Electro98/cyber-growbox-2077/README.md

# cyber-growbox-2077
This is the most epic student's growbox ever.
We hope that this project will help us to grow plants that will look 
like plants from Plants vs Zombies.
