Electro98/cyber-growbox-2077/blueprints/main_part.stl

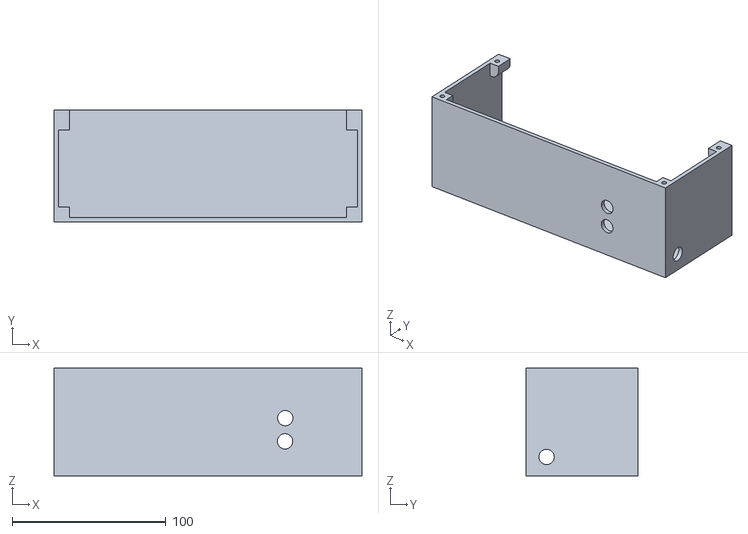
[picture p1: CAD file, 2021-03-17]
blueprints/main_part.stl
200.0 x 73.0 x 70.0
