Electro98/cyber-growbox-2077/blueprints/engine_mount.step

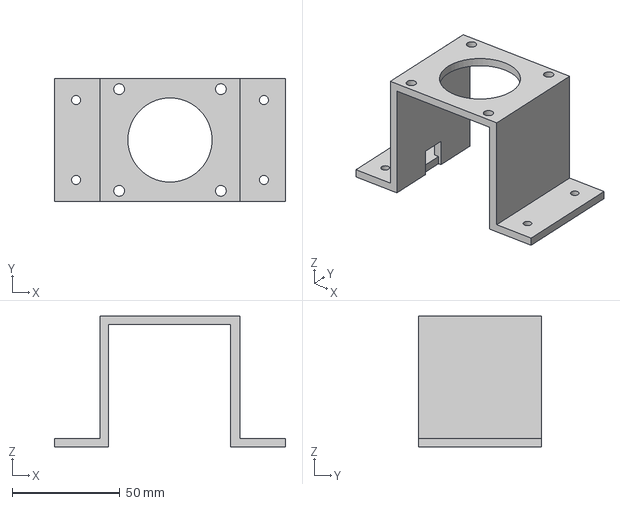
[picture p2: CAD file, 2021-03-21]
blueprints/engine_mount.step
107.0 x 57.0 x 60.6 mm
