Electro98/cyber-growbox-2077/blueprints/top_mount.step

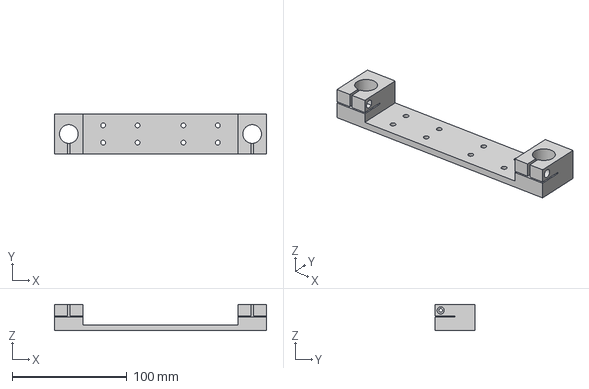
[picture p3: CAD file, 2021-03-21]
blueprints/top_mount.step
185.0 x 35.0 x 23.0 mm
