Electro98/cyber-growbox-2077/blueprints/bottom_mount.step

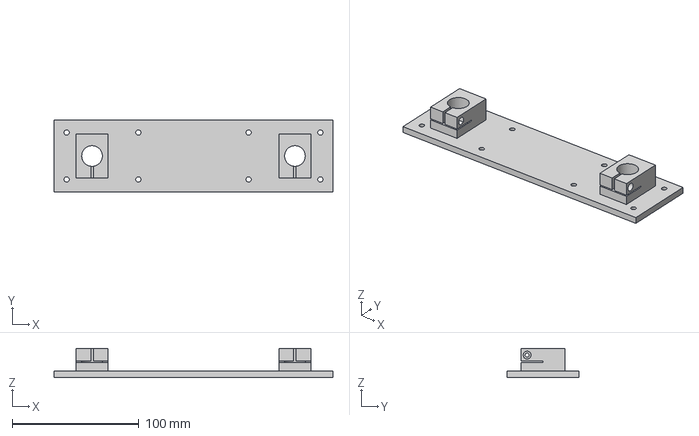
[picture p4: CAD file, 2021-03-21]
blueprints/bottom_mount.step
220.0 x 57.0 x 23.0 mm
