Electro98/cyber-growbox-2077/blueprints/carriage.step

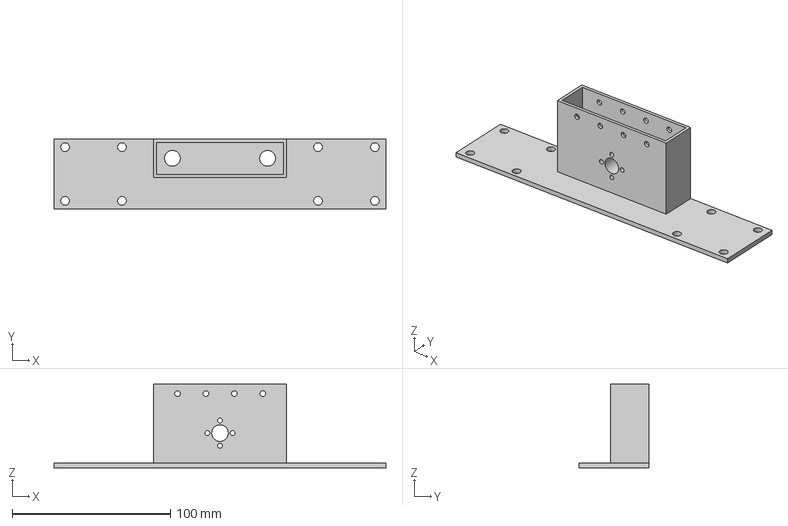
[picture p5: CAD file, 2021-03-21]
blueprints/carriage.step
210.0 x 44.0 x 53.0 mm
