Electro98/cyber-growbox-2077/(list of files, cad)

Other CAD files:
blueprints/bottom_mount.stl
blueprints/carriage.stl
blueprints/engine_mount.stl
blueprints/top_mount.stl
