Electro98/cyber-growbox-2077/circuit_boards/Schematic_OvermindsFarm_main.pdf

# +5VGND_3.3

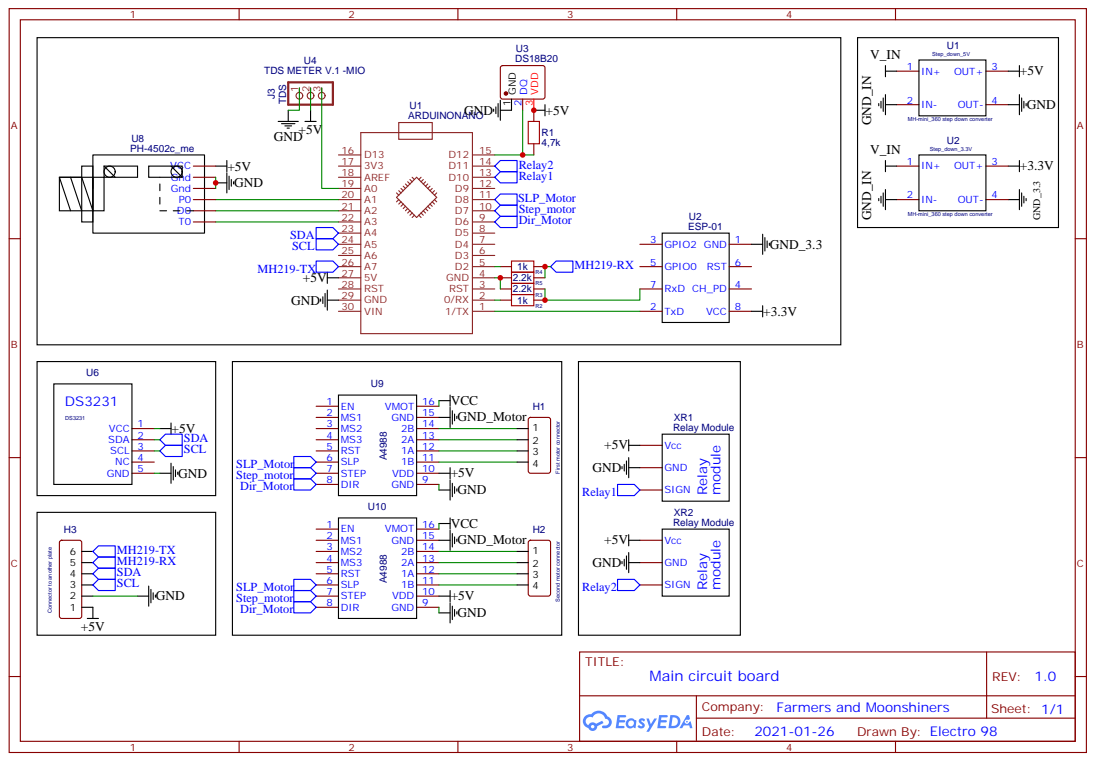
[picture p6: page 1]

MH-mini_360 step down converter

Connector to another plate

Company: Farmers and Moonshiners
