Electro98/cyber-growbox-2077/circuit_boards/Schematic_OvermindsFarm_part_2.pdf

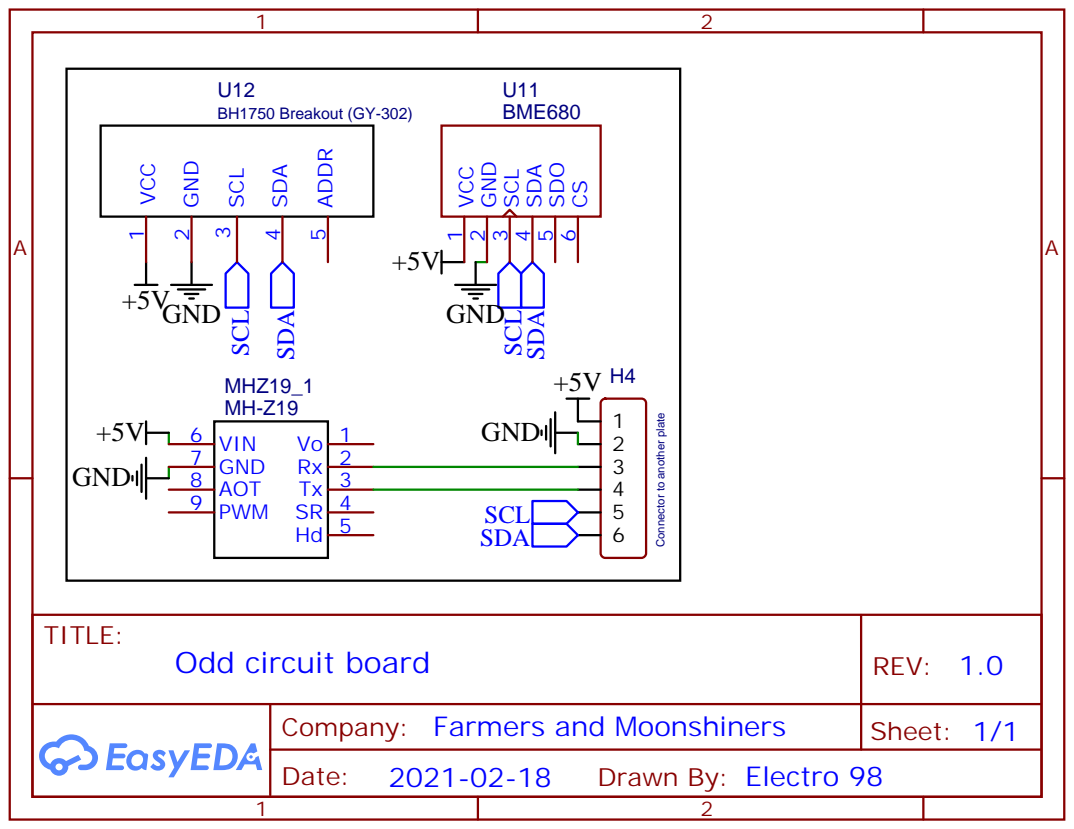
[picture p7: page 1]

Connector to another plate

Company: Farmers and Moonshiners
