Electro98/cyber-growbox-2077/TODO.md

# TODO

Задачи для проекта "GrowBox". 

## Работа с платой

- [x] Ознакомление с подключением драйверов шаговых двигателей A4988 @Electro98
- [x] Ознакомление с подключением DS18B20 @Electro98
- [x] Ознакомление с подключением GY-302 @Timofey-arch
- [x] Ознакомление с подключением BME680 @Timofey-arch
- [ ] Ознакомление с подключением MH-Z19 @Electro98
- [ ] Ознакомление с подключением DS3231 @SerLap-ctrl
- [ ] Ознакомление с подключением ESP-01 @SerLap-ctrl
- [x] Ознакомление с подключением датчиком PH @Electro98
- [ ] Ознакомление с подключением датчиком TDS @SerLap-ctrl
- [ ] Ознакомление с подключением и работой реле @Timofey-arch
- [ ] Проектирование платы @Electro98
- [ ] Сборка платы @Electro98
- [ ] Проектирование корпуса (опционально)

## Прошивка

- [ ] Создание и конфигурирование проекта для Arduino Nano 
- [ ] Функция для работы с DS18B20 (вывод в сериал порт) @Electro98
- [x] Функция для работы с GY-302 (вывод в сериал порт) @Timofey-arch
- [ ] Функция для работы с BME680 (вывод в сериал порт) @Timofey-arch
- [ ] Функция для работы с MH-Z19 (вывод в сериал порт) @Electro98
- [ ] Функция для работы с датчиком PH (вывод в сериал порт) @Electro98
- [ ] Функция для работы с датчиком TDS (вывод в сериал порт) @SerLap-ctrl
- [ ] Функция для работы с реле (для включения/выключения ламп и насоса) @Timofey-arch
- [ ] Функция для чтения данных со всех датчиков по таймеру DS3231 @SerLap-ctrl
- [ ] Функция для отправки данных на сервер по WiFi через ESP-01 @SerLap-ctrl
- [ ] Функция управления шаговыми двигателями @Electro98
- [ ] Сборка общей прошивки

## Сервер

- [ ] Прием данных с устройства
- [ ] Визуализация
- [ ] Управление устройством:
    - [ ] Двигателями
    - [ ] Лампами
    - [ ] Насосом
- [ ] Выбор БД для хранения данных с датчиков
- [ ] Добавление работы с БД
