Electro98/cyber-growbox-2077/growbox_sketch/src/setup.h

#ifndef SETUP_H
#define SETUP_H

#define DS18B20_PIN 12  // Pin D12
#define PINSENSOR A7
#define BH1750_PIN_1 4  //Pin A4
#define BH1750_PIN_2 5  //Pin A5
#define CO2_TX A6       //Pin A6
#define CO2_RX 2        //Pin D2
#define BME_CS 0        //Pin D
#define BME_MOSI 0      //Pin D
#define BME_MISO 0      //Pin D
#define BME_SCK 0       //Pin D

#endif
