Electro98/cyber-growbox-2077/(commit log)

2021-02-17 Обновил прогресс в TODO
2021-02-18 Добавлена первая версия логотипа
2021-02-20 Добавлен файл Contributing
2021-03-02 Завершён функционал управления моторами, указанный в issue №4.
    [main.cpp]
2021-03-02 Модифицирован gitignore. Удалены лишние файлы.
2021-03-02 :bug:Подобрано более подходящее название директории.
    [main.cpp]
2021-03-08 :blue_book: добавлена модель каретки #9
    [carriage.step, carriage.stl]
2021-03-08 :wrench:Исправлен баг позиционирования и добавлено управление реле
    Позиционирование теперь относительное, добавлена реализация управления реле через команды с сохранением предыдущего функционала.
    [main.cpp]
2021-03-09 :blue_book: Добавлены первые версии принципиальных схем плат. Close #1.
2021-03-09 Добавлена функция считывания уровня освещенности #5
2021-03-09 Добавлена вторая версия логотипа #12
    (я надеюсь что последняя)
2021-03-09 Изменена функция считывания уровня освещенности
    Вынесен весь лишний код из функции в loop
    Изменен формат файла на cpp
    Изменено местоположение файла
2021-03-09 :wrench: И снова изменена функция считывания уровня освещенности #5
    Исправлена сбитая кодировка
    Теперь функция возвращает uint16_t
2021-03-09 Был обновлен прогресс в TODO
    Ну и чутка подправлен README проекта
2021-03-17 :wrench: Добавлена функция TDS_Meter
2021-03-17 Добавлен файл 3D-модели корпуса
    [main_part.stl]
2021-03-17 :wrench: Реализованы фукции для датчика DS18B20
    Функции считывания данных температуры и установки разрешения датчика
2021-03-21 :blue_book: бновлена модель каретки
    [carriage.step, carriage.stl]
2021-03-21 :blue_book: обавлена модель нижнего крепления
    [bottom_mount.step, bottom_mount.stl]
2021-03-21 :blue_book: обавлена модель верхнего крепления
    [top_mount.step, top_mount.stl]
2021-03-21 :blue_book: обавлена модель крепления двигателя
    [engine_mount.step, engine_mount.stl]
2021-03-22 :art: Была объявлена функция getLux #17
2021-03-24 :bug: Были возвращены 2 важные потерянные строчки
    [main.cpp]
2021-03-24 :wrench: :art: Удалены лишние файлы, добавлены пины для подключения датчиков
2021-03-24 :wrench: Сделана тестовая прошивка на модуль esp-01
2021-03-25 :wrench: Добавления функции в библиотеку
2021-03-29 Реализована функция для датчика CO2.
2021-03-31 Была исправлена функция TDS
    Был убран файл и исправлены названия пина
    [sensors.cpp, setup.h]
2021-04-03 :scissors: Добавлены файлы, связанные с python
2021-04-03 :arrow_up: Добавлены зависимости python
2021-04-03 :snake: Добавлен пример отправки и обработки запроса на flask #22
2021-04-07 Добавлено пару строчек в сервер для тестов
2021-04-13 :snake:Реализован минимальный сервер
2021-04-14 Создано CI Hello World
2021-04-15 :snake:Добавлена прошивка для esp v0.1
2021-04-26 :wrench:Изменены функции отправки данных
    Изменены функции отправки данных между Arduino и ESP-01.
2021-04-29 :wrench:Добавлен парс JSON
2021-05-03 :snake:Изменение интерфейса, чуть лучше код страниц
    Изменён главный интерфейс сайта, удалена таблица, сделаны адеквантные кнопки. Переписан код страниц, теперь есть шапка на сайте, страницы стали гибче. Данные с сайта теперь уходят только в post запросах в json и приходят тоже, только в json.
2021-05-05 :snake::arrow_up: Добавлен график, исправлен баг
    Добавлен график создающийся по данным из базы. Исправлен баг декоратора для работы с бд.
2021-05-12 :wrench: Добавлена функция для датчика BME680
2021-05-13 :wrench: Добавлены функции считывания отдельных параметров датчика BME680.
    Была изменена функция airQualityIndex - теперь она возвращает тип float.
    Добавлены пины для подключения BME680.
    Были объявлены все новые функции в файле sensors.h.
2021-05-13 :wrench: Удалено лишнее в функции setupBME680
2021-05-16 :wrench: Поправлены баги и добавлено пару зависимостей
2021-05-17 :wrench::snake:Добавлена система переключения на ручное управление, добавлена функция отправления команд на ESP
2021-05-18 добавлена функция времени.
2021-05-18 переделана функция времени
    функция отправляет данные сразу
2021-05-18 Подготовка к отправке данных на сервер
2021-05-20 :wrench: Переименнована переменная sensors. Closes #31. Починена отправка данных на сервер.
2021-05-20 :wrech::arrow_up: Добавлена библиотека ds3231, исправлены ошибки слияния
    [esp_test_sketch.ino, main.cpp, sensors.cpp, sensors.h, setup.h]
2021-05-24 :snake:Реализована система добавления данных в таблицу
2021-05-25 :snake: Переделан главный шаблон
2021-06-02 :snake::wrench: Перевёрстано меню, возможность получить графики всех параметров, фикс мелких ошибок
2021-07-04 :snake::fire: Произошёл переход на InfluxDB
2021-07-07 :wrench: Реализована свзять по шине I2C. closes #38
2021-07-08 :snake::arrow_up: Добавлен тестовый вариант реализации обновления графиков в real-time
2021-07-08 :snake: добавлено разделение данных на клиенте. closes #40
2021-07-08 :snake::arrow_down::art: небольшая чистка кода и удаление пару ненужных импортов
2021-07-08 :wrench::art: небольшая чистка кода прошивки для ESP-01
2021-07-08 :wrench::art: неьолбшая чистка кода прошивки для arduino
